zacharesmer/imac_g3_ivad_board_init/imacG3IvadInit/imacG3IvadInit.ino

//Rocky Hill


/*
   This sketch waits for button presses to turn on/off the iMac G3 CRT
   circuitry and send the init sequence to the IVAD board.
   if you are planning to just send the init sequence on startup, you
   can uncomment "initIvadBoard();"  in setup(). It uses software i2c
   lines.

   it also sends edid information when requested via i2c on port 0x50.
   The Edid information is for an iMac G3 DV and it sends the three
   supported modes.

   1024x768 @ 75 Hz
   800x600 @ 95 Hz
   640x480 @ 117 Hz

   In order for this program to work, the i2c transmit buffer length
   constants must be changed in two files. The Wire library has two
   buffers it uses for i2c transmissions

   "BUFFER_LENGTH" in
   "arduino_install_folder/hardware/arduino/avr/libraries/Wire/src/Wire.h"

   and

   "TWI_BUFFER_LENGTH" in
   "arduino_install_folder/hardware/arduino/avr/libraries/Wire/src/utility/twi.h"

   Both of these must be changed from 32 to 128 to be able to transmit
   the edid byte array in one shot.

   To test this program, you can directly wire SDA(pin 12),SCL(pin 15)
   and GND(pin 6) pins from your computers VGA portbdirectly into the
   corresponding pins on the arduino.


*/


/*
  Uses SoftwareWire from the arduino libraries. install with library
  manager or from https://github.com/Testato/SoftwareWire
*/

#include "ivad.h"
#include "imacG3IvadInit.h"
#include <EEPROMWearLevel.h>
#include <SoftwareWire.h>
#include <Wire.h>


//starting monitor property values.
byte verticalPositionValueIndex = 0x4d;//77
byte contrastValueIndex = 0xfe;
byte horizontalPositionValueIndex = 0xb0;//176
byte heightValueIndex = 0xf0;//240
byte widthValueIndex = 0x19;//25
byte brightnessValueIndex = 0x0a;
byte parallelogramValueIndex = 0xc6;//198
byte keystoneValueIndex = 0x9b;//155
byte rotationValueIndex = 0x42;//66
byte pincushionValueIndex = 0xcb;//203

byte SERIAL_BUFFER[SERIAL_BUFFER_MAX_SIZE];
byte SERIAL_BUFFER_DATA_SIZE;
byte CURRENT_CONFIG[CONFIG_EEPROM_SLOTS];
byte FIRST_RUN = 0x79;

byte data = -1;

//define solid state relay and power button pins
byte solid_state_relay_Pin = 7;

byte powerButtonPin = 3;
//int powerButtonPin = 13;

//define state variables
byte externalCircuitState = LOW;
byte buttonState = LOW;

//vsync pin
byte vsyncPin = 10;


//vsync power off countdown in seconds
byte vsync_off_time = 180;

//counters
byte buttonPressedTime = 0;
byte vsyncDetect = 0;
unsigned long currentTime = 0;
unsigned long startTime = 0;
unsigned long elapsedTime = 0;

//The init sequence is sent on a software i2c bus.
// sda is on 4 and scl is on 5
SoftwareWire softWire( 4, 5);




void setup() {

  //define pin direction
  pinMode(solid_state_relay_Pin, OUTPUT);
  pinMode(powerButtonPin, INPUT);
  pinMode(vsyncPin, INPUT);//this pin is used to monitor VSYNC.
  pinMode(8, INPUT);//this pin is on the J5 connector for general use PB0.
  pinMode(9, INPUT);//this pin is on the J5 connector for general use PB1.

  EEPROMwl.begin(CONFIG_EEPROM_VERSION, CONFIG_EEPROM_SLOTS + 1);
  Wire.begin(0x50); //join as slave and wait for EDID requests
  softWire.setClock(50000);
  softWire.begin();// join as master and send init sequence
  Serial.begin(115200);//use built in serial
  Serial.setTimeout(1000);

  Wire.onRequest(requestEvent); //event handler for requests from master
  Wire.onReceive(receiveData); // event handler when receiving from  master
  // turn it all off
  externalCircuitOff();

  //check to see if it's the 1st time running after burning firmware
  FIRST_RUN = EEPROMwl.read(CONFIG_EEPROM_SLOTS);
  if (FIRST_RUN != 0x79 ) {
    EEPROMwl.update(CONFIG_EEPROM_SLOTS, 0x79);
    settings_reset_default();
    settings_store();
    settings_load();
    ivad_write_settings();
  }//end if



  //externalCircuitOn();


}//end setup

//byte x = 0;
/*
   This loops looks for button presses, turns the circuit on or off, and
   listens for characters on the serial port to make screen adjustments.
*/
void loop() {

  buttonState = digitalRead(powerButtonPin);

  // do stuff only when the CRT is on
  if ( externalCircuitState == HIGH ) {

    currentTime = millis();
    elapsedTime = currentTime - startTime;


    serial_processing();


    //increment vsyncDetect everytime vsync is detected
    if (pulseIn(vsyncPin, HIGH, 10000) > 0) {

      if (vsyncDetect < vsync_off_time) {
        vsyncDetect++;
      }//end if
      startTime = currentTime = millis();
    }//end if


    //decrement vsyncDetect whenever one second elapses
    if (elapsedTime >= 1000 && vsyncDetect > 0) {
      vsyncDetect--;
      startTime = currentTime = millis();
    }

    //do stuff whn vsyncDetect is 0
    if (vsyncDetect <= 0) {
      startTime = 0;
      currentTime = 0;
       externalCircuitOff();


    }

  }//end if


  if (buttonState == LOW )
  {
    if (buttonPressedTime <= 10) {
      buttonPressedTime++;
    }//end if



  }
  else
  {
    //buttonPressedTime = 0;

  }

  //turn everything off if button is pressed for 10 ms
  if (buttonPressedTime > 0 && externalCircuitState == HIGH && buttonState == HIGH) {
    externalCircuitOff();
    buttonPressedTime = 0;

  }

  //turn everything on if button is pressed for 10 ms
  if (buttonPressedTime > 0 && externalCircuitState == LOW  && buttonState == HIGH) {
    externalCircuitOn();
    buttonPressedTime = 0;
    startTime = millis();
    currentTime = millis();
    vsyncDetect = vsync_off_time;

  }




}//end loop



void handleSerial(char incoming) {
  /*
  Type ? for controls help
  */

  //if (Serial.available() > 0) {
  // char incoming = Serial.read();

  int index = -1;
  bool increment = true;
  switch (incoming) {
    case 'a'://move left
      //moveHorizontal(+1);
      index = IVAD_SETTING_HORIZONTAL_POS;
      break;
    case 'd'://move right
      //moveHorizontal(-1);
      index = IVAD_SETTING_HORIZONTAL_POS;
      increment = false;
      break;
    case 'w'://move up
      //moveVertical(-1);
      index = IVAD_SETTING_VERTICAL_POS;
      increment = false;
      break;
    case 's'://move down
      //moveVertical(+1);
      index = IVAD_SETTING_VERTICAL_POS;
      break;
    case '_'://make skinnier
      //changeWidth(+1);
      index = IVAD_SETTING_WIDTH;
      break;
    case '+'://make fatter
      //changeWidth(-1);
      index = IVAD_SETTING_WIDTH;
      increment = false;
      break;
    case '='://make taller
      //changeHeight(+1);
      index = IVAD_SETTING_HEIGHT;
      break;
    case '-'://make shorter
      //changeHeight(-1);
      index = IVAD_SETTING_HEIGHT;
      increment = false;
      break;
    case '<'://decrease contrast
      //changeContrast(-1);
      index = IVAD_SETTING_CONTRAST;
      increment = false;
      break;
    case '>'://increase contrast
      //changeContrast(+1);
      index = IVAD_SETTING_CONTRAST;
      break;
    case '['://decrease brightness
      //changeBrightness(-1);
      index = IVAD_SETTING_BRIGHTNESS;
      increment = false;
      break;
    case ']'://increase brightness
      // changeBrightness(+1);
      index = IVAD_SETTING_BRIGHTNESS;
      break;
    // case '{'://decrease brightness drive
    //   //changeBrightness(-1);
    //   index = IVAD_SETTING_BRIGHTNESS_DRIVE;
    //   increment = false;
    //   break;
    // case '}'://increase brightness drive
    //   // changeBrightness(+1);
    //   index = IVAD_SETTING_BRIGHTNESS_DRIVE;
    //   break;
    case '1'://tilt paralellogram left
      //changeParallelogram(+1);
      index = IVAD_SETTING_PARALLELOGRAM;
      break;
    case '2'://tilt paralellogram right
      //changeParallelogram(-1);
      index = IVAD_SETTING_PARALLELOGRAM;
      increment = false;
      break;
    case '3'://keystone pinch top
      //changeKeystone(-1);
      index = IVAD_SETTING_KEYSTONE;
      increment = false;
      break;
    case '4'://keystone pinch bottom
      //changeKeystone(+1);
      index = IVAD_SETTING_KEYSTONE;
      break;
    case '5'://rotate left
      //changeRotation(+1);
      index = IVAD_SETTING_ROTATION;
      break;
    case '6'://rotate right
      //changeRotation(-1);
      index = IVAD_SETTING_ROTATION;
      increment = false;
      break;
    case '7'://pincushion pull corners out
      //changePincushion(-1);
      index = IVAD_SETTING_PINCUSHION;
      increment = false;
      break;
    case '8'://pincushion pull corners in
      //changePincushion(+1);
      index = IVAD_SETTING_PINCUSHION;
      break;
    case 'p':
      printCurrentSettings();
      break;
    case 'q':
      settings_store();
      Serial.println("Settings stored.");
      break;
    case 'r':
      index =  IVAD_SETTING_RED_DRIVE;
      increment = false;
      break;
    case 'R':
      index =  IVAD_SETTING_RED_DRIVE;
      break;
    case 'g':
      index =  IVAD_SETTING_GREEN_DRIVE;
      increment = false;
      break;
    case 'G':
      index =  IVAD_SETTING_GREEN_DRIVE;
      break;
    case 'b':
      index =  IVAD_SETTING_BLUE_DRIVE;
      increment = false;
      break;
    case 'B':
      index =  IVAD_SETTING_BLUE_DRIVE;
      break;
    case 'X': // reload settings from eeprom
      settings_load();
      ivad_write_settings();
      break;
    case 'o'://power off
      if ( externalCircuitState == HIGH ) {
        externalCircuitOff();
      }//end if
      break;
    case '?':
      Serial.println(F("----------------------------"));
      Serial.println(F("|        Controls          |"));
      Serial.println(F("----------------------------"));
      Serial.println("    w = move up");
      Serial.println("    a = move left");
      Serial.println("    s = move down");
      Serial.println("    d = move right");
      Serial.println("");
      Serial.println("    _ = skinnier");
      Serial.println("    + = fatter");
      Serial.println("    = = taller");
      Serial.println("    - = shorter");
      Serial.println("");
      Serial.println("    < = contrast down");
      Serial.println("    > = contrast up");
      Serial.println("");
      Serial.println("    [ = brightness down");
      Serial.println("    ] = brightness up");
      // Serial.println("");
      // Serial.println("    { = brightness drive down");
      // Serial.println("    } = brightness drive up");
      Serial.println("");
      Serial.println("    r = less red");
      Serial.println("    R = more red");
      Serial.println("    g = less green");
      Serial.println("    G = more green");
      Serial.println("    b = less blue");
      Serial.println("    B = more blue");
      Serial.println("");
      Serial.println("");
      Serial.println("    1 = Parallelogram left");
      Serial.println("    2 = Parallelogram right");
      Serial.println("    3 = Keystone pinch top");
      Serial.println("    4 = Keystone pinch bottom");
      Serial.println("    5 = Rotate left");
      Serial.println("    6 = Rotate right");
      Serial.println("    7 = Pincushion pull corners out");
      Serial.println("    8 = Pincushion pull corners in");
      Serial.println("");
      Serial.println("    p = Print current settings");
      Serial.println("    q = Save current settings");
      Serial.println("");
      Serial.println("    o = Turn off display");
      Serial.println("");
      Serial.println("    ? = Print controls");
      Serial.println(F("----------------------------"));
      break;
  }
  //}

  if (index > -1) {
    int val = CURRENT_CONFIG[index];
    int result = 0;
    if (increment) {
      result = ivad_increment_setting(index);
    }
    else
    {
      result = ivad_decrement_setting(index);
    }
    Serial.println(result, HEX);
  }//end if


}//end handleSerial

void printCurrentSettings() {
  Serial.println(F("----------------------------"));
  Serial.println(F("|     Current settings     |"));
  Serial.println(F("----------------------------"));
  Serial.print(F("Contrast: "));
  Serial.println(CURRENT_CONFIG[IVAD_SETTING_CONTRAST], HEX);           // = 0x00    0XB5 - 0XFF
  Serial.print(F("Red drive: "));
  Serial.println(CURRENT_CONFIG[IVAD_SETTING_RED_DRIVE], HEX);          // = 0x01    0X00 - 0XFF
  Serial.print(F("Green drive: "));
  Serial.println(CURRENT_CONFIG[IVAD_SETTING_GREEN_DRIVE], HEX);        // = 0x02    0X00 - 0XFF
  Serial.print(F("Blue drive: "));
  Serial.println(CURRENT_CONFIG[IVAD_SETTING_BLUE_DRIVE], HEX);         // = 0x03    0X00 - 0XFF
  Serial.print(F("Red cutoff: "));
  Serial.println(CURRENT_CONFIG[IVAD_SETTING_RED_CUTOFF], HEX);         // = 0x04    0X00 - 0XFF
  Serial.print(F("Green cutoff: "));
  Serial.println(CURRENT_CONFIG[IVAD_SETTING_GREEN_CUTOFF], HEX);       // = 0x05    0X00 - 0XFF
  Serial.print(F("Blue cutoff: "));
  Serial.println(CURRENT_CONFIG[IVAD_SETTING_BLUE_CUTOFF], HEX);        // = 0x06    0X00 - 0XFF
  Serial.print(F("Horizontal position: "));
  Serial.println(CURRENT_CONFIG[IVAD_SETTING_HORIZONTAL_POS], HEX);     // = 0x07    0X80 - 0XFF
  Serial.print(F("Height: "));
  Serial.println(CURRENT_CONFIG[IVAD_SETTING_HEIGHT], HEX);             // = 0x08    0X80 - 0XFF
  Serial.print(F("Vertical position: "));
  Serial.println(CURRENT_CONFIG[IVAD_SETTING_VERTICAL_POS], HEX);       // = 0x09    0X00 - 0X7F
  Serial.print(F("S Correction: "));
  Serial.println(CURRENT_CONFIG[IVAD_SETTING_S_CORRECTION], HEX);       // = 0x0A    0X80 - 0XFF
  Serial.print(F("Keystone: "));
  Serial.println(CURRENT_CONFIG[IVAD_SETTING_KEYSTONE], HEX);           // = 0x0B    0X80 - 0XFF
  Serial.print(F("Pincushion: "));
  Serial.println(CURRENT_CONFIG[IVAD_SETTING_PINCUSHION], HEX);         // = 0x0C    0X80 - 0XFF
  Serial.print(F("Width: "));
  Serial.println(CURRENT_CONFIG[IVAD_SETTING_WIDTH], HEX);              // = 0x0D    0X00 - 0X7F
  Serial.print(F("Pincushion balance: "));
  Serial.println(CURRENT_CONFIG[IVAD_SETTING_PINCUSHION_BALANCE], HEX); // = 0x0E    0X80 - 0XFF
  Serial.print(F("Parallelogram: "));
  Serial.println(CURRENT_CONFIG[IVAD_SETTING_PARALLELOGRAM], HEX);      // = 0x0F    0X80 - 0XFF
  Serial.print(F("Brightness drive: "));
  Serial.println(CURRENT_CONFIG[IVAD_SETTING_BRIGHTNESS_DRIVE], HEX);   // = 0x10
  Serial.print(F("Brightness: "));
  Serial.println(CURRENT_CONFIG[IVAD_SETTING_BRIGHTNESS], HEX);         // = 0x11    0X00 - 0X0A
  Serial.print(F("Rotation: "));
  Serial.println(CURRENT_CONFIG[IVAD_SETTING_ROTATION], HEX);           // = 0x12    0X00 - 0X7F
  Serial.println(F("----------------------------"));

}

void writeToIvad(byte address, byte message) {
  softWire.beginTransmission(address);
  delay(1);
  softWire.write(message);
  softWire.endTransmission();
  delay(39);
}//end method

void writeToIvad(byte address, byte message1, byte message2) {
  softWire.beginTransmission(address);
  delay(1);
  softWire.write(message1);
  softWire.write(message2);
  softWire.endTransmission();
  delay(39);
}//end method

void  readFromIvad(byte address, byte bytes) {
  char buf[bytes + 1];
  byte bytesRead = 0;
  softWire.requestFrom(address, bytes);
  while (softWire.available())
  {
    char c = softWire.read();
    buf[bytesRead++] = c;
  }
  buf[bytesRead] = '\0';
  delay(50);
}//end method


void initIvadBoard() {

//  //init sequence 2 <---this is the one that works well with my iMac G3, Rocky Hill
//  writeToIvad( IVAD_REGISTER_PROPERTY, IVAD_SETTING_WIDTH, 0x00);
//  readFromIvad(IVAD_REGISTER_PROPERTY, 1);
//  writeToIvad( IVAD_REGISTER_PROPERTY, IVAD_SETTING_VERTICAL_POS, 0x00);
//  writeToIvad( 0x53, 0x33);
//  readFromIvad(0x53, 1);
//  writeToIvad( IVAD_REGISTER_PROPERTY, IVAD_SETTING_WIDTH, 0x0B);
//  writeToIvad( IVAD_REGISTER_PROPERTY, IVAD_SETTING_CONTRAST, 0x00); //setting contrast to 0x00 seems to turn something on.
//  writeToIvad( IVAD_REGISTER_PROPERTY, IVAD_SETTING_HEIGHT, 0xE4);
//  writeToIvad( IVAD_REGISTER_PROPERTY, IVAD_SETTING_ROTATION, 0xC9);
//  writeToIvad( 0x53, 0x00);
//  readFromIvad(0x53, 10);
//  writeToIvad( 0x53, 0x0A);
//  readFromIvad(0x53, 10);
//  writeToIvad( 0x53, 0x14);
//  readFromIvad(0x53, 10);
//  writeToIvad( 0x53, 0x1E);
//  readFromIvad(0x53, 10);
//  writeToIvad( 0x53, 0x28);
//  readFromIvad(0x53, 10);
//  writeToIvad( 0x53, 0x32);
//  readFromIvad(0x53, 10);
//  writeToIvad( 0x53, 0x3C);
//  readFromIvad(0x53, 10);
//  writeToIvad( 0x53, 0x46);
//  readFromIvad(0x53, 10);
//  writeToIvad( 0x53, 0x50);
//  readFromIvad(0x53, 10);
//  writeToIvad( 0x53, 0x5A);
//  readFromIvad(0x53, 2);
//  writeToIvad( IVAD_REGISTER_PROPERTY, CONFIG_OFFSET_RED_CUTOFF,         VIDEO_CONFIG_DEFAULT[ CONFIG_OFFSET_RED_CUTOFF ]        );
//  writeToIvad( IVAD_REGISTER_PROPERTY, CONFIG_OFFSET_GREEN_CUTOFF,       VIDEO_CONFIG_DEFAULT[ CONFIG_OFFSET_GREEN_CUTOFF ]      );
//  writeToIvad( IVAD_REGISTER_PROPERTY, CONFIG_OFFSET_BLUE_CUTOFF,        VIDEO_CONFIG_DEFAULT[ CONFIG_OFFSET_BLUE_CUTOFF ]       ); 
//  writeToIvad( IVAD_REGISTER_PROPERTY, CONFIG_OFFSET_HORIZONTAL_POS,     VIDEO_CONFIG_DEFAULT[ CONFIG_OFFSET_HORIZONTAL_POS ]    );
//  writeToIvad( IVAD_REGISTER_PROPERTY, CONFIG_OFFSET_HEIGHT,             VIDEO_CONFIG_DEFAULT[ CONFIG_OFFSET_HEIGHT ]            );
//  writeToIvad( IVAD_REGISTER_PROPERTY, CONFIG_OFFSET_VERTICAL_POS,       VIDEO_CONFIG_DEFAULT[ CONFIG_OFFSET_VERTICAL_POS ]      );
//  writeToIvad( IVAD_REGISTER_PROPERTY, CONFIG_OFFSET_S_CORRECTION,       VIDEO_CONFIG_DEFAULT[ CONFIG_OFFSET_S_CORRECTION ]      );
//  writeToIvad( IVAD_REGISTER_PROPERTY, CONFIG_OFFSET_KEYSTONE,           VIDEO_CONFIG_DEFAULT[ CONFIG_OFFSET_KEYSTONE ]          );
//  writeToIvad( IVAD_REGISTER_PROPERTY, CONFIG_OFFSET_PINCUSHION,         VIDEO_CONFIG_DEFAULT[ CONFIG_OFFSET_PINCUSHION ]        );
//  writeToIvad( IVAD_REGISTER_PROPERTY, CONFIG_OFFSET_WIDTH,              VIDEO_CONFIG_DEFAULT[ CONFIG_OFFSET_WIDTH ]             );
//  writeToIvad( IVAD_REGISTER_PROPERTY, CONFIG_OFFSET_PINCUSHION_BALANCE, VIDEO_CONFIG_DEFAULT[ CONFIG_OFFSET_PINCUSHION_BALANCE ]);
//  writeToIvad( IVAD_REGISTER_PROPERTY, CONFIG_OFFSET_PARALLELOGRAM,      VIDEO_CONFIG_DEFAULT[ CONFIG_OFFSET_PARALLELOGRAM ]     );
//  writeToIvad( IVAD_REGISTER_PROPERTY, CONFIG_OFFSET_RESERVED6,          VIDEO_CONFIG_DEFAULT[ CONFIG_OFFSET_RESERVED6 ]         ); // brightness
//  writeToIvad( IVAD_REGISTER_PROPERTY, CONFIG_OFFSET_BRIGHTNESS,         VIDEO_CONFIG_DEFAULT[ CONFIG_OFFSET_BRIGHTNESS ]        );
//  writeToIvad( IVAD_REGISTER_PROPERTY, CONFIG_OFFSET_ROTATION,           VIDEO_CONFIG_DEFAULT[ CONFIG_OFFSET_ROTATION ]          );
//  writeToIvad( IVAD_REGISTER_PROPERTY, CONFIG_OFFSET_CONTRAST,           VIDEO_CONFIG_DEFAULT[ CONFIG_OFFSET_CONTRAST ]          );



     //provided by anothere
      writeToIvad( 0x46,0x13,0x00);
      writeToIvad(0x46,0x13,0x00);
      readFromIvad(0x46,1);
      writeToIvad(0x46,0x09,0x00);
      writeToIvad(0x53,0x33);
      readFromIvad(0x53,1);
      writeToIvad(0x46,0x13,0x0b);
      writeToIvad(0x46,0x00,0x00);
      writeToIvad(0x46,0x08,0xe4);
      writeToIvad(0x46,0x12,0xc9);
      writeToIvad(0x53,0x00);
      readFromIvad(0x53,10);
      writeToIvad(0x53,0x0a);
      readFromIvad(0x53,10);
      writeToIvad(0x53,0x14);
      readFromIvad(0x53,10);
      writeToIvad(0x53,0x1e);
      readFromIvad(0x53,10);
      writeToIvad(0x53,0x28);
      readFromIvad(0x53,10);
      writeToIvad(0x53,0x32);
      readFromIvad(0x53,10);
      writeToIvad(0x53,0x3c);
      readFromIvad(0x53,10);
      writeToIvad(0x53,0x46);
      readFromIvad(0x53,10);
      writeToIvad(0x53,0x50);
      readFromIvad(0x53,10);
      writeToIvad(0x53,0x5a);
      readFromIvad(0x53,10);
      writeToIvad(0x46,0x01,0x82);
      writeToIvad(0x46,0x02,0x82);
      writeToIvad(0x46,0x03,0x82);
      writeToIvad(0x46,0x04,0xa0);
      writeToIvad(0x46,0x05,0xa0);
      writeToIvad(0x46,0x06,0xa0);
      writeToIvad(0x46,0x07,0xad);
      writeToIvad(0x46,0x08,0xe4);
      writeToIvad(0x46,0x09,0x3d);
      writeToIvad(0x46,0x0a,0x9e);
      writeToIvad(0x46,0x0b,0xb4);
      writeToIvad(0x46,0x0c,0xc4);
      writeToIvad(0x46,0x0d,0x27);
      writeToIvad(0x46,0x0e,0xbf);
      writeToIvad(0x46,0x0f,0xc0);
      writeToIvad(0x46,0x10,0x40);
      writeToIvad(0x46,0x11,0x0a);
      writeToIvad(0x46,0x12,0x5b);
      writeToIvad(0x46,0x00,0xff);
      writeToIvad(0x53,0x00);
      readFromIvad(0x53,10);
      writeToIvad(0x53,0x10);
      readFromIvad(0x53,10);
      writeToIvad(0x53,0x20);
      readFromIvad(0x53,10);
      writeToIvad(0x53,0x30);
      readFromIvad(0x53,10);
      writeToIvad(0x46,0x11,0x05);
      writeToIvad(0x46,0x00,0xff);
      writeToIvad(0x46,0x00,0x00);
      writeToIvad(0x46,0x07,0xb1);
      writeToIvad(0x46,0x0d,0x10);
      writeToIvad(0x46,0x0c,0xc7);
      writeToIvad(0x46,0x09,0x4a);
      writeToIvad(0x46,0x08,0xea);
      writeToIvad(0x46,0x0f,0xc0);
      writeToIvad(0x46,0x0b,0xae);
      writeToIvad(0x46,0x12,0x5b);
      writeToIvad(0x46,0x00,0xff);
      writeToIvad(0x46,0x11,0x05);
      writeToIvad(0x46,0x00,0xff);
      writeToIvad(0x46,0x10,0x40);
      writeToIvad(0x46,0x06,0xa0);
      writeToIvad(0x46,0x05,0xa0);
      writeToIvad(0x46,0x04,0xa0);
      writeToIvad(0x46,0x03,0x82);
      writeToIvad(0x46,0x02,0x82);
      writeToIvad(0x46,0x01,0x82);
      writeToIvad(0x46,0x11,0x05);
      writeToIvad(0x46,0x00,0xff);
      writeToIvad(0x46,0x11,0x05);
      writeToIvad(0x46,0x00,0xff);
      writeToIvad(0x46,0x10,0x40);
      writeToIvad(0x46,0x06,0xa0);
      writeToIvad(0x46,0x05,0xa0);
      writeToIvad(0x46,0x04,0xa0);
      writeToIvad(0x46,0x03,0x82);
      writeToIvad(0x46,0x02,0x82);
      writeToIvad(0x46,0x01,0x82);
      writeToIvad(0x46,0x11,0x05);
      writeToIvad(0x46,0x00,0xff);


  // // my very own bespoke init code recorded from a 600MHz imac (plus this first bit that it doesn't work without)
  // writeToIvad( 0x46,0x13,0x00);
  // writeToIvad(0x46,0x13,0x00);
  // readFromIvad(0x46,1);
  // writeToIvad(0x46,0x09,0x00);
  // writeToIvad(0x53,0x33);
  // readFromIvad(0x53,1);
  // writeToIvad(0x46,0x13,0x0b);
  // writeToIvad(0x46,0x00,0x00);
  // writeToIvad(0x46,0x08,0xe4);
  // writeToIvad(0x46,0x12,0xc9);

  // writeToIvad(0x53, 0x00);
  // readFromIvad(0x53, 10);
  // writeToIvad(0x53, 0x0A);
  // readFromIvad(0x53, 10);
  // writeToIvad(0x53, 0x14);
  // readFromIvad(0x53, 10);
  // writeToIvad(0x53, 0x1E);
  // readFromIvad(0x53, 10);
  // writeToIvad(0x53, 0x28);
  // readFromIvad(0x53, 10);
  // writeToIvad(0x53, 0x32);
  // readFromIvad(0x53, 10);
  // writeToIvad(0x53, 0x3C);
  // readFromIvad(0x53, 10);
  // writeToIvad(0x53, 0x46);
  // readFromIvad(0x53, 10);
  // writeToIvad(0x53, 0x50);
  // readFromIvad(0x53, 10);
  // writeToIvad(0x53, 0x5A);
  // readFromIvad(0x53, 2);
  // // Marker A
  // writeToIvad(0x46, 0x01, 0x89);
  // writeToIvad(0x46, 0x02, 0x88);
  // writeToIvad(0x46, 0x03, 0x84);
  // writeToIvad(0x46, 0x04, 0x52);
  // writeToIvad(0x46, 0x05, 0x63);
  // writeToIvad(0x46, 0x06, 0x54);
  // writeToIvad(0x46, 0x07, 0xAE);
  // writeToIvad(0x46, 0x08, 0xEC);
  // writeToIvad(0x46, 0x09, 0x44);
  // writeToIvad(0x46, 0x0A, 0x9E);
  // writeToIvad(0x46, 0x0B, 0x9E);
  // writeToIvad(0x46, 0x0C, 0xCF);
  // writeToIvad(0x46, 0x0D, 0x25);
  // writeToIvad(0x46, 0x0E, 0xBE);
  // writeToIvad(0x46, 0x0F, 0xD3);
  // writeToIvad(0x46, 0x10, 0x40);
  // writeToIvad(0x46, 0x11, 0x05);
  // writeToIvad(0x46, 0x12, 0x42);
  // writeToIvad(0x46, 0x00, 0xFF);
}


void solid_state_relayOn() {
  digitalWrite(solid_state_relay_Pin, HIGH);

}

void solid_state_relayOff() {
  digitalWrite(solid_state_relay_Pin, LOW);

}




//these are probably too much but they are here in case I would lke to add more stuff to turn on and off
void externalCircuitOn() {
  solid_state_relayOn();
  delay(1000);
  initIvadBoard();
  settings_load();
  ivad_write_settings();
  externalCircuitState = HIGH;
}

void externalCircuitOff() {
  solid_state_relayOff();
  externalCircuitState = LOW;

}



// function that executes whenever data is requested by master
// this function is registered as an event.
void requestEvent() {
  //delay(500);
  Wire.write(edid, 128);



}//end method
// function that executes whenever data is received by the slave


void receiveData(byte byteCount) {


  while (Wire.available()) {
    data = Wire.read();
  }
}


/*
  This is my implementation of oshimai's communications protocol.
  Clearly I borrowed heavily from his sketch and I purposely
  kept the same variable names to make it easier to port any
  changes he might make to his sletch. There are parts I didn't
  bother to port, verifying the checksum for example because of
  time constraints. I might implement the rest in the future.

*/
void serial_processing()
{

  byte b ;

  if (Serial.available()) {

    do
    {
      b = Serial.read();
      SERIAL_BUFFER[SERIAL_BUFFER_DATA_SIZE++] = b;
    }
    while (Serial.available() &&  b != SERIAL_EOL_MARKER);


    //call other serial handler
    if (SERIAL_BUFFER_DATA_SIZE != 9)
    {
      if (SERIAL_BUFFER[0] != 0x07) {
        SERIAL_BUFFER_DATA_SIZE = 0;
        handleSerial((char)b);
      }
      return;

    }


    SERIAL_BUFFER_DATA_SIZE = 0;

    byte id = SERIAL_BUFFER[1];
    byte cmd = SERIAL_BUFFER[2];
    byte valA = SERIAL_BUFFER[3];
    byte valB = SERIAL_BUFFER[4];

    switch (cmd)
    {

      case 0x01: // Get EEPROM Version
        {
          byte ret[8] { 0x06, id, 0x01, CONFIG_EEPROM_VERSION, 0x03, 0xFF, 0x04, SERIAL_EOL_MARKER };
          ret[5] = checksum(ret, 5);
          Serial.write(ret, 8);
        }
        break;

      case 0x02: // Dump SRAM Config
        {
          byte ret[7 + CONFIG_EEPROM_SLOTS];
          ret[0] = 0x06;
          ret[1] = SERIAL_BUFFER[1];
          ret[2] = CONFIG_EEPROM_SLOTS;

          for (int i = 0; i < CONFIG_EEPROM_SLOTS; i++)
            ret[3 + i] = CURRENT_CONFIG[i];

          ret[2 + CONFIG_EEPROM_SLOTS + 1] = 0x03;
          ret[2 + CONFIG_EEPROM_SLOTS + 2] = checksum(ret, 2 + CONFIG_EEPROM_SLOTS + 1 + 1);
          ret[2 + CONFIG_EEPROM_SLOTS + 3] = 0x04;
          ret[2 + CONFIG_EEPROM_SLOTS + 4] = SERIAL_EOL_MARKER;
          Serial.write(ret, 7 + CONFIG_EEPROM_SLOTS);
        }
        break;

      case 0x03: // IVAD Change Setting
        {
          ivad_change_setting(valA, valB);
          byte ret[7] { 0x06, id, 0x00, 0x03, 0xFF, 0x04, SERIAL_EOL_MARKER };
          ret[4] = checksum(ret, 4);
          Serial.write(ret, 7);
        }
        break;

      case 0x04: // IVAD Reset from EEPROM
        {
          settings_load();
          byte ret[7] { 0x06, id, 0x00, 0x03, 0xFF, 0x04, SERIAL_EOL_MARKER };
          ret[4] = checksum(ret, 4);
          Serial.write(ret, 7);
        }
        break;

      case 0x05: // EEPROM Reset to Default
        {
          settings_reset_default();
          settings_store();
          settings_load();
          ivad_write_settings();
          byte ret[7] { 0x06, id, 0x00, 0x03, 0xFF, 0x04, SERIAL_EOL_MARKER };
          ret[4] = checksum(ret, 4);
          Serial.write(ret, 7);
        }
        break;

      case 0x06: // Write SRAM to EEPROM
        {
          settings_store();
          byte ret[7] { 0x06, id, 0x00, 0x03, 0xFF, 0x04, SERIAL_EOL_MARKER };
          ret[4] = checksum(ret, 4);
          Serial.write(ret, 7);
        }
    }//end switch

    SERIAL_BUFFER[1] = 0xFF;

  }

}//end if









//===================================



byte checksum(const byte arr[], const int len)
{
  int sum = 1; // Checksum may never be 0.

  for (int i = 0; i < len; i++)
    sum += arr[i];

  byte ret = 256 - (sum % 256);

  return ret;
}




int ivad_change_setting(const int ivad_setting,  const byte value)
{

  CURRENT_CONFIG[ivad_setting] = value;

  if (CURRENT_CONFIG[ivad_setting] < VIDEO_CONFIG_MIN[ivad_setting]) CURRENT_CONFIG[ivad_setting] = VIDEO_CONFIG_MIN[ivad_setting];
  if (CURRENT_CONFIG[ivad_setting] > VIDEO_CONFIG_MAX[ivad_setting]) CURRENT_CONFIG[ivad_setting] = VIDEO_CONFIG_MAX[ivad_setting];

  writeToIvad(IVAD_REGISTER_PROPERTY, ivad_setting, CURRENT_CONFIG[ivad_setting]);
  CURRENT_CONFIG[CONFIG_OFFSET_CHECKSUM] = checksum(CURRENT_CONFIG, CONFIG_EEPROM_SLOTS - 1);

  return 0;
}

int ivad_increment_setting(const int ivad_setting) {
  if (CURRENT_CONFIG[ivad_setting] < VIDEO_CONFIG_MAX[ivad_setting]) {
      CURRENT_CONFIG[ivad_setting] ++;
      writeToIvad(IVAD_REGISTER_PROPERTY, ivad_setting, CURRENT_CONFIG[ivad_setting]);
      CURRENT_CONFIG[CONFIG_OFFSET_CHECKSUM] = checksum(CURRENT_CONFIG, CONFIG_EEPROM_SLOTS - 1);
  }
  return CURRENT_CONFIG[ivad_setting];
}


int ivad_decrement_setting(const int ivad_setting) {
  if (CURRENT_CONFIG[ivad_setting] > VIDEO_CONFIG_MIN[ivad_setting]) {
      CURRENT_CONFIG[ivad_setting] --;
      writeToIvad(IVAD_REGISTER_PROPERTY, ivad_setting, CURRENT_CONFIG[ivad_setting]);
      CURRENT_CONFIG[CONFIG_OFFSET_CHECKSUM] = checksum(CURRENT_CONFIG, CONFIG_EEPROM_SLOTS - 1);
  }
  return CURRENT_CONFIG[ivad_setting];
}



/*
  This function loads the monitor property values from the EEPROM
  into variables.
*/
void settings_load()
{
  // Set something so a checksum mismatch can trigger if there's nothing in the EEPROM.

  for (byte eeprom_memory_offset = 0 ; eeprom_memory_offset < CONFIG_EEPROM_SLOTS ; eeprom_memory_offset++) {
    CURRENT_CONFIG[eeprom_memory_offset] = EEPROMwl.read(eeprom_memory_offset);
  }//end for

  byte loaded_checksum = CURRENT_CONFIG[CONFIG_OFFSET_CHECKSUM];
  byte expected_checksum = checksum(CURRENT_CONFIG, CONFIG_EEPROM_SLOTS - 1);

  if (loaded_checksum != expected_checksum)
  {
    //settings_reset_default();
    settings_store();
  }


}

void ivad_write_settings()
{

  for (int IVAD_SETTING = 0 ; IVAD_SETTING < IVAD_SETTING_END ;  IVAD_SETTING ++ )
  {
    writeToIvad(IVAD_REGISTER_PROPERTY, IVAD_SETTING, CURRENT_CONFIG[IVAD_SETTING]);
  }

}



void settings_store()
{

  //compute current config checksum and store it.
  byte current_config_checksum = checksum(CURRENT_CONFIG, CONFIG_EEPROM_SLOTS - 1);

  CURRENT_CONFIG[CONFIG_OFFSET_CHECKSUM] = current_config_checksum;

  for (byte eeprom_memory_offset = 0 ; eeprom_memory_offset < CONFIG_EEPROM_SLOTS ; eeprom_memory_offset++) {
    EEPROMwl.update(eeprom_memory_offset, CURRENT_CONFIG[eeprom_memory_offset]);
  }//end for


}


void settings_reset_default()
{

  //compute current config checksum and store it.
  byte current_config_checksum = checksum(CURRENT_CONFIG, CONFIG_EEPROM_SLOTS - 1);

  CURRENT_CONFIG[CONFIG_OFFSET_CHECKSUM] = current_config_checksum;

  for (byte eeprom_memory_offset = 0 ; eeprom_memory_offset < CONFIG_EEPROM_SLOTS ; eeprom_memory_offset++) {
    CURRENT_CONFIG[eeprom_memory_offset] = VIDEO_CONFIG_DEFAULT[eeprom_memory_offset];
  }//end for



}
