zacharesmer/imac_g3_ivad_board_init/(commit log)

2026-03-30 Use an in-stock capacitor in J22 board
    Also add the regenerated gerbers
    [imac_g3_slot_loading_J22_adapter_board-B_Cu.gbr, imac_g3_slot_loading_J22_adapter_board-B_Mask.gbr, imac_g3_slot_loading_J22_adapter_board-B_Paste.gbr, imac_g3_slot_loading_J22_adapter_board-B_Silkscreen.gbr, imac_g3_slot_loading_J22_adapter_board-Edge_Cuts.gbr, imac_g3_slot_loading_J22_adapter_board-F_Cu.gbr, imac_g3_slot_loading_J22_adapter_board-F_Mask.gbr, imac_g3_slot_loading_J22_adapter_boa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]
2026-03-30 Update bill of materials
    - Use a different capacitor that is still manufactured
    - Swap the expensive 3M header for a cheaper amphenol
    [bill_of_materials.csv]
2026-03-30 make bill of materials format match
    [bill_of_materials.csv]
2026-03-30 swap out obsolete crystal
    [bill_of_materials.csv]
2026-03-30 remove old kicad project
2026-03-30 update capacitor
    [bill_of_materials.csv]
2026-03-30 update crystal
    [bill_of_materials.csv]
2026-04-12 Add init recording to arduino code
    Add an init sequence recorded from my mac
    Also change the display adjustment key bindings to be a
    little easier to use from minicom.
    Fix an overflow when changing the settings (maxing out settings
    was wrapping around to the minimum value)
    [imacG3IvadInit.ino]
2026-04-14 Adjust the keyboard layout for adjusting settings
    Also make "p" actually print current settings, instead of the original
    default ones.
    And add a help message to print which letters change which settings.
